apop274/Computer-Vision-Turret/cad/solidworks/README.md

Put the SolidWorks source files here (.SLDPRT / .SLDASM), plus STEP exports
(File → Save As → STEP AP214) so people without SolidWorks can open them.
