apop274/Computer-Vision-Turret/cad/stl/CameraMount.stl

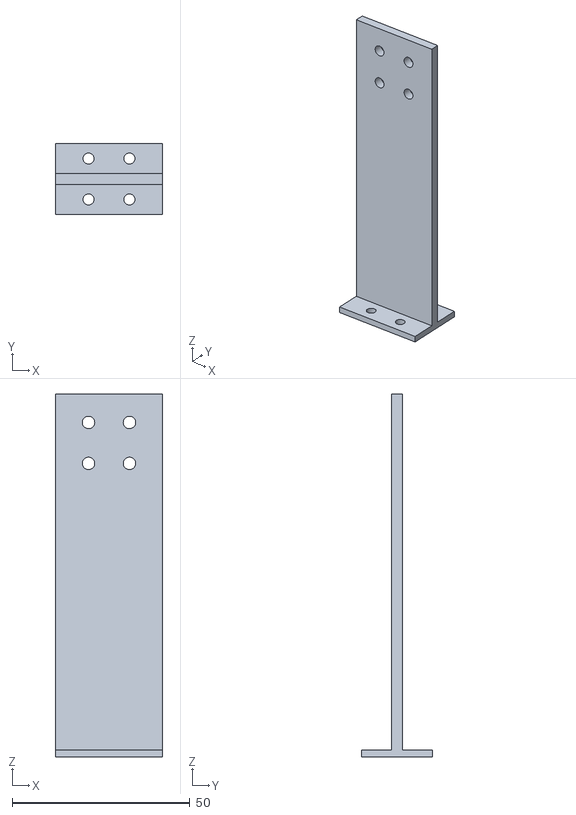
[picture p5: CAD file, 2026-10-31]
cad/stl/CameraMount.stl
30.0 x 20.0 x 102.0
