apop274/Computer-Vision-Turret/cad/stl/EnclosureLid.stl

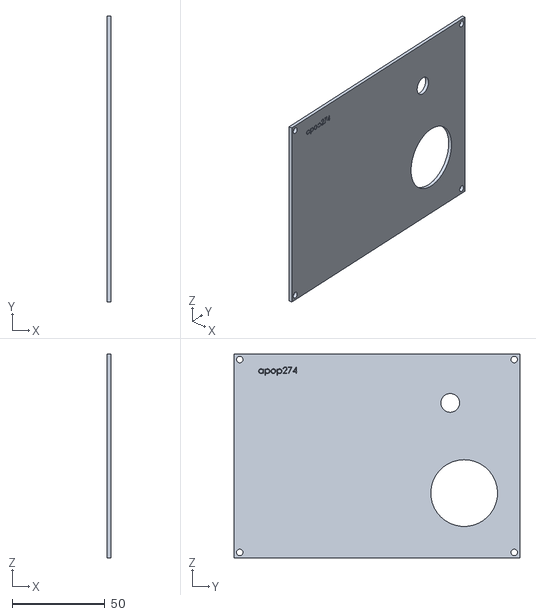
[picture p6: CAD file, 2026-10-31]
cad/stl/EnclosureLid.stl
2.00 x 154.0 x 110.0
