apop274/Computer-Vision-Turret/cad/stl/CameraTiltMount_test.stl

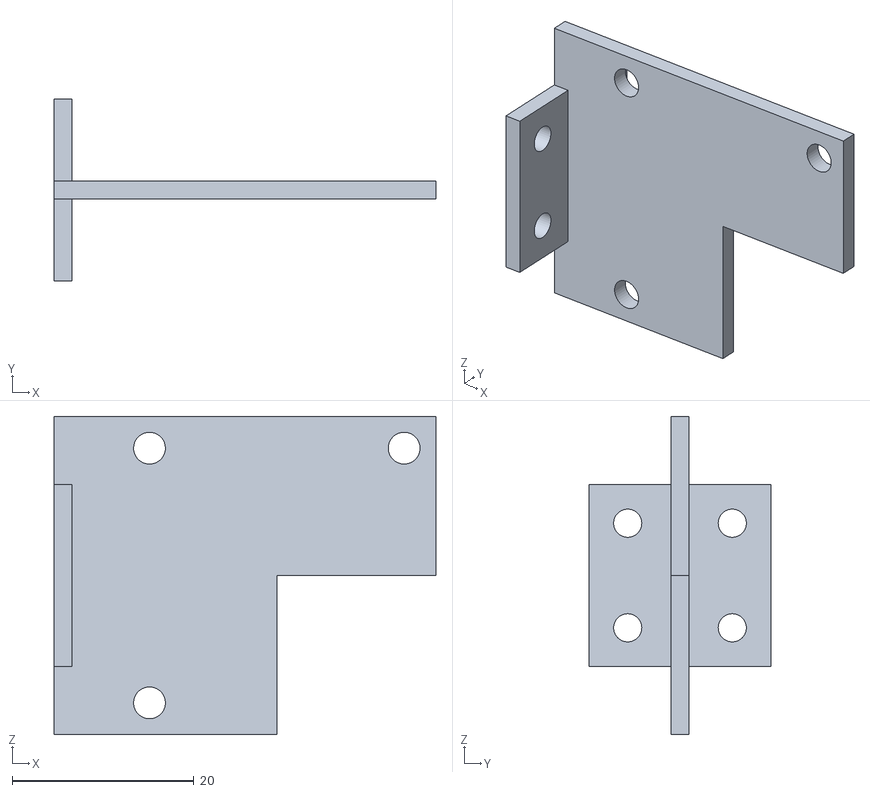
[picture p7: CAD file, 2026-10-31]
cad/stl/CameraTiltMount_test.stl
42.0 x 20.0 x 35.0
