apop274/Computer-Vision-Turret/cad/stl/Enclosure.stl

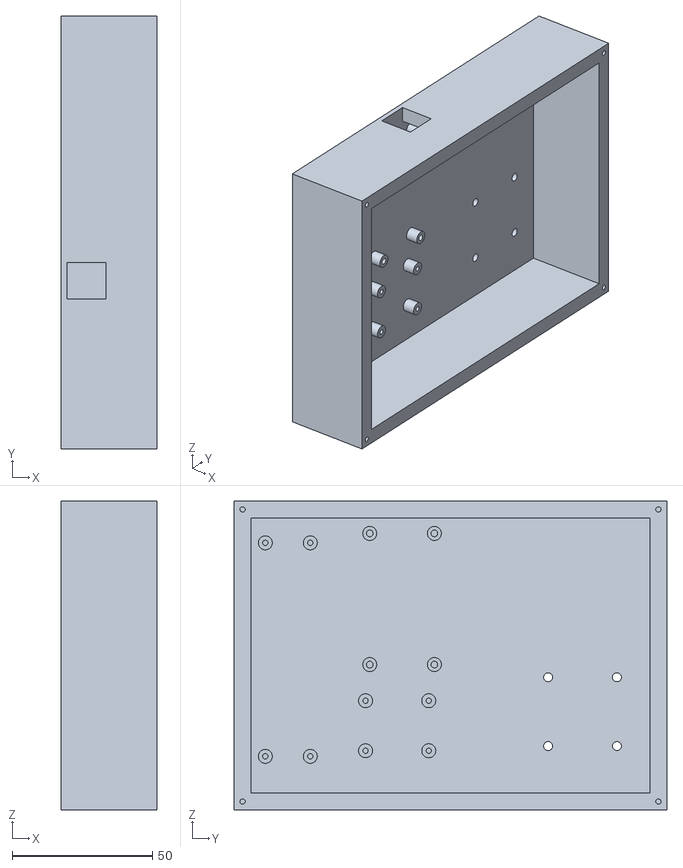
[picture p8: CAD file, 2026-10-31]
cad/stl/Enclosure.stl
34.0 x 154.0 x 110.0
